rushikesh-D69/tara_hardware/docs/README.md

# docs/ — Documentation

Project documentation for the TARA ADAS system.

---

## Contents

| File | Description |
|---|---|
| `setup_guide.md` | Step-by-step hardware wiring, OS setup, and first-run instructions |

---

## See Also

- [`../walkthrough.md`](../walkthrough.md) — End-to-end system walkthrough
- [`../rpi/README.md`](../rpi/README.md) — Raspberry Pi software reference
- [`../esp32/README.md`](../esp32/README.md) — ESP32 firmware and dashboard reference
