rushikesh-D69/tara_hardware/docs/PICS/README.md

# docs/PICS — Photo Gallery

Real hardware photos and generated diagrams from the TARA project.

---

## Real Hardware Photos

| File | Description |
|---|---|
| `Final_position.png` | TARA mid-circuit — full arena view with car, signs, and traffic light |
| `Final_track.jpeg` | Top-down view of the complete test track (before car is placed) |
| `Turning_Seq.png` | Robot executing a turn at a directional landmark |
| `road_track.jpeg` | Camera-level view of a directional sign inside the lane |
| `PIN CONNECTIONS IN SCHEMATIC.jpeg` | ESP32 GPIO reference (TB6612FNG, HC-SR04, MPU-6050, encoders) |
| `TARA-Circuit Schematic -1.png` | Full circuit schematic (Fritzing) |
| `obstrucle_detection_avoidance.gif` | Demo GIF of obstacle detection and avoidance manoeuvre |
| `tara_live_camera_view.html` | Standalone HTML viewer for the MJPEG debug stream |

---

## Generated / Enhanced Images

| File | Description |
|---|---|
| `tara_robot_hero.png` | Enhanced photo — TARA on track, cinematic edit |
| `tara_track_overview.png` | Enhanced track top-down with highlighted lane lines and signs |
| `tara_live_debug.png` | Enhanced lab photo showing MJPEG debug stream on laptop |
| `tara_system_architecture.png` | System architecture diagram (RPi ↔ ESP32 ↔ Dashboard) |

---

## Track Legend

The indoor test arena uses:
- **White insulation tape** — dual lane lines on glossy marble floor
- **Blue circular signs** — directional arrows (left, right, straight)
- **Red STOP sign** — triggers TSR hard stop
- **Smartphone** — displays traffic light image for TLR testing

All images are referenced in [`../../walkthrough.md`](../../walkthrough.md).
