rushikesh-D69/tara_hardware/docs/PICS/Final_position.png

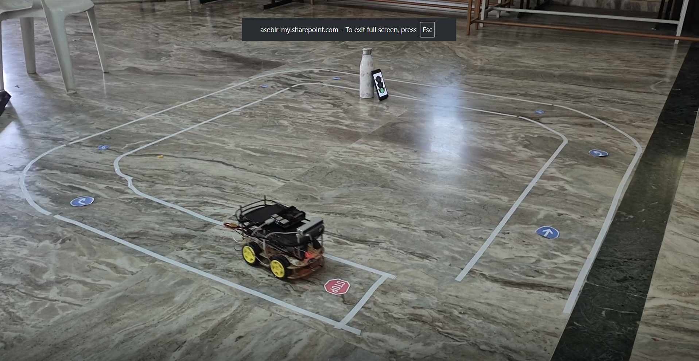
docs/PICS/Final_position.png
