rushikesh-D69/tara_hardware/docs/PICS/Final_track.jpeg

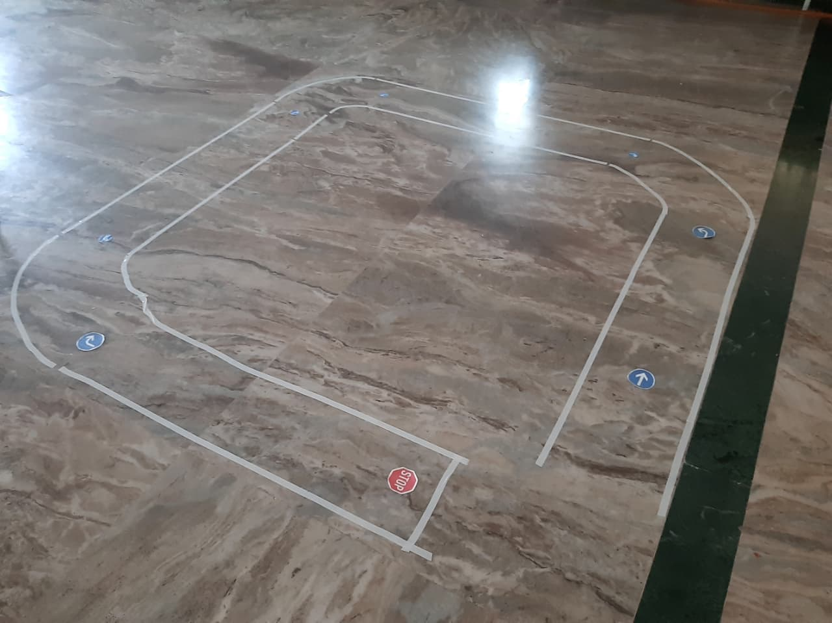
docs/PICS/Final_track.jpeg
