rushikesh-D69/tara_hardware/docs/PICS/PIN CONNECTIONS IN SCHEMATIC.jpeg

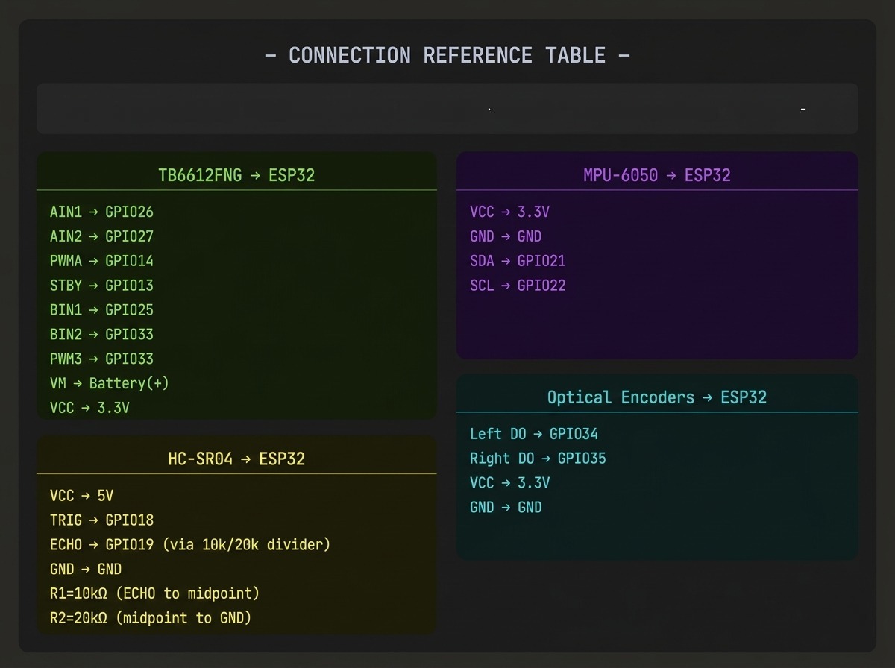
docs/PICS/PIN CONNECTIONS IN SCHEMATIC.jpeg
