rushikesh-D69/tara_hardware/docs/PICS/Proposed_track.jpeg

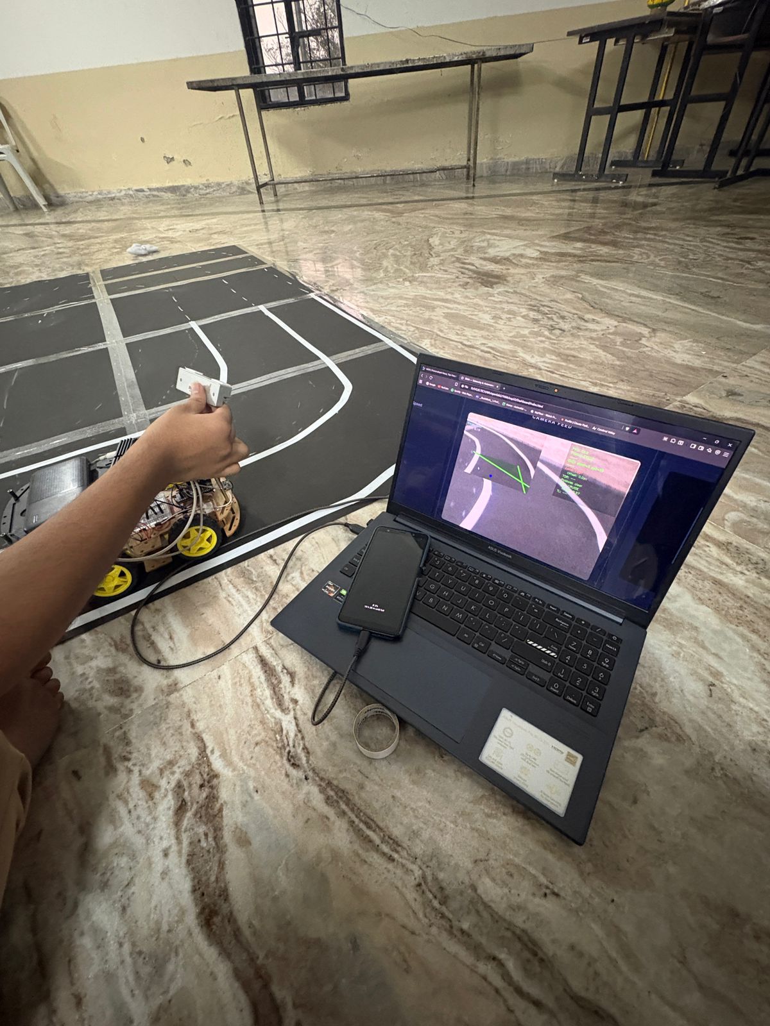
docs/PICS/Proposed_track.jpeg
