rushikesh-D69/tara_hardware/docs/PICS/road_track.jpeg

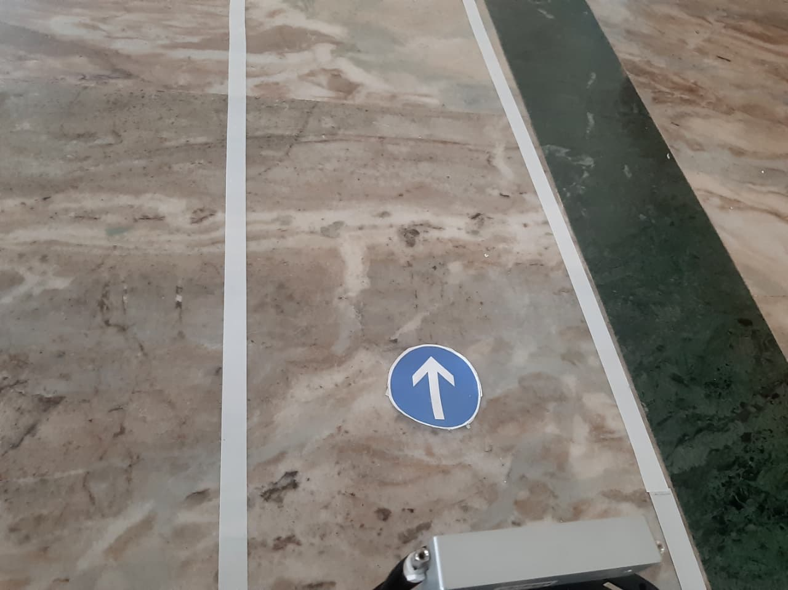
docs/PICS/road_track.jpeg
