rushikesh-D69/tara_hardware/docs/PICS/TARA-Circuit Schematic -1.png

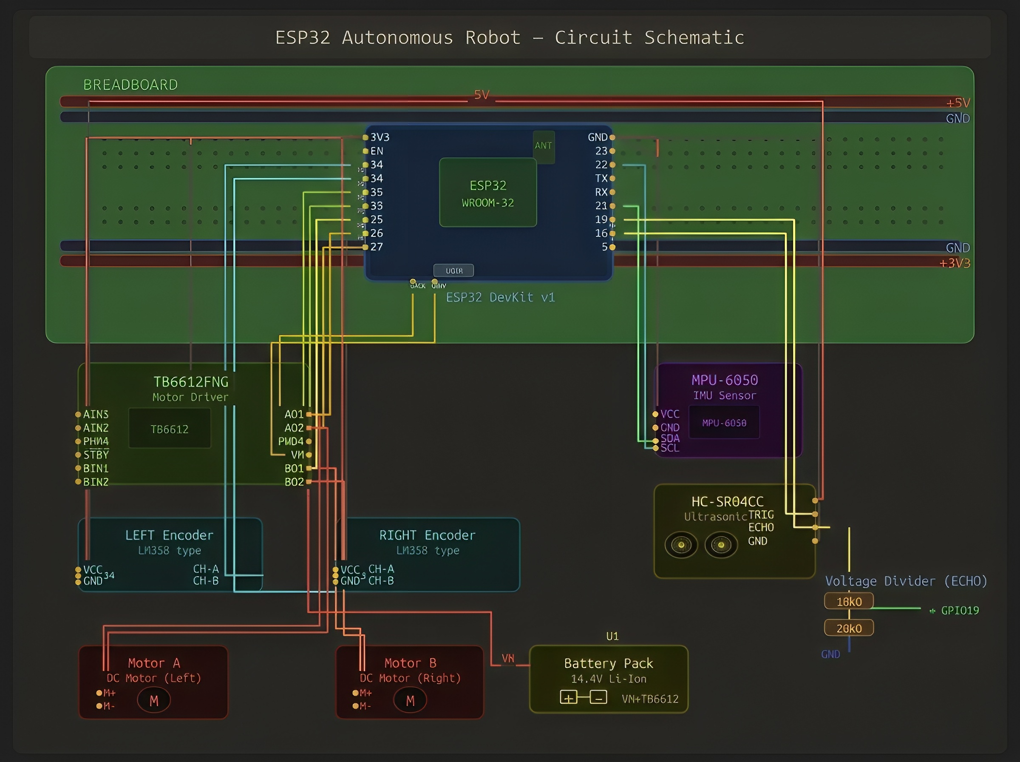
docs/PICS/TARA-Circuit Schematic -1.png
