rushikesh-D69/tara_hardware/docs/PICS/Turning_Seq.png

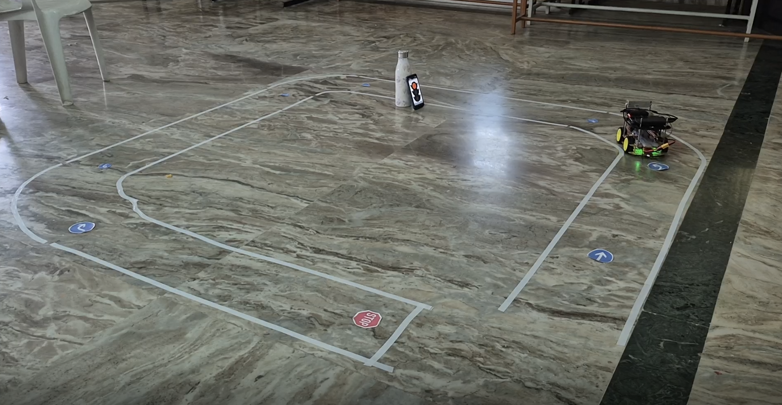
docs/PICS/Turning_Seq.png
