rushikesh-D69/tara_hardware/rpi/print_sheets/traffic_signs.pdf

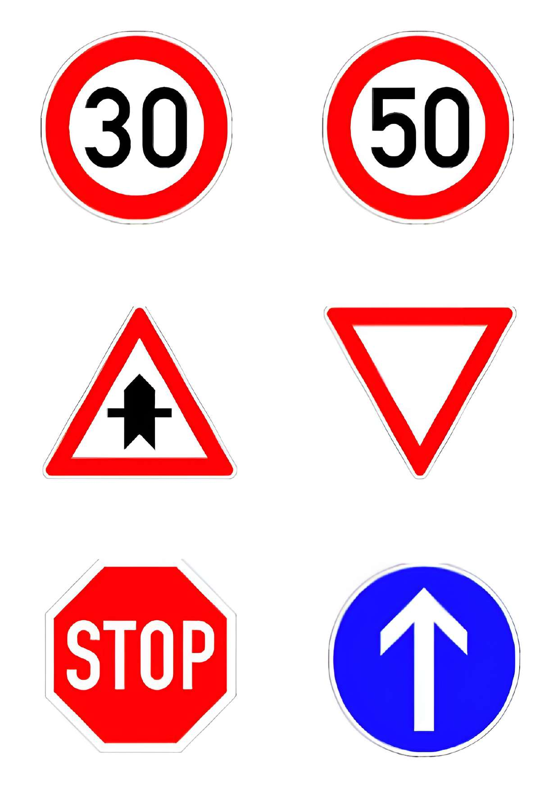
[picture p12: page 1]
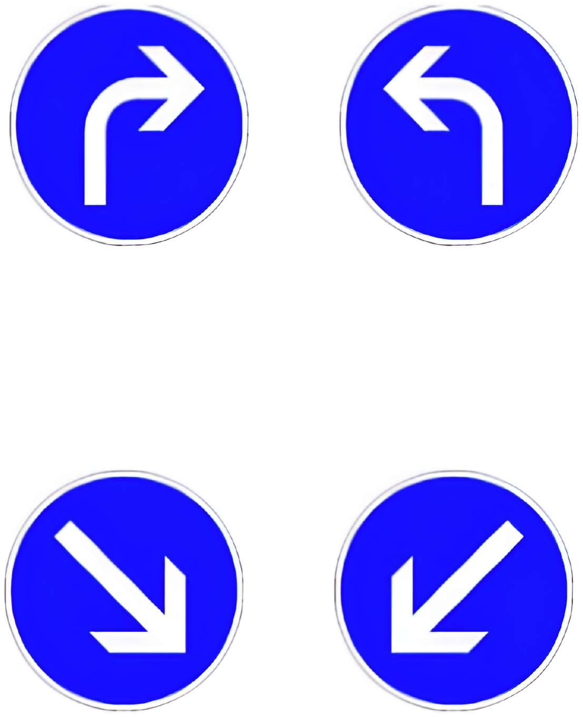
[picture p13: page 2]
