rushikesh-D69/tara_hardware/rpi/print_sheets/sign_sheet_2.png

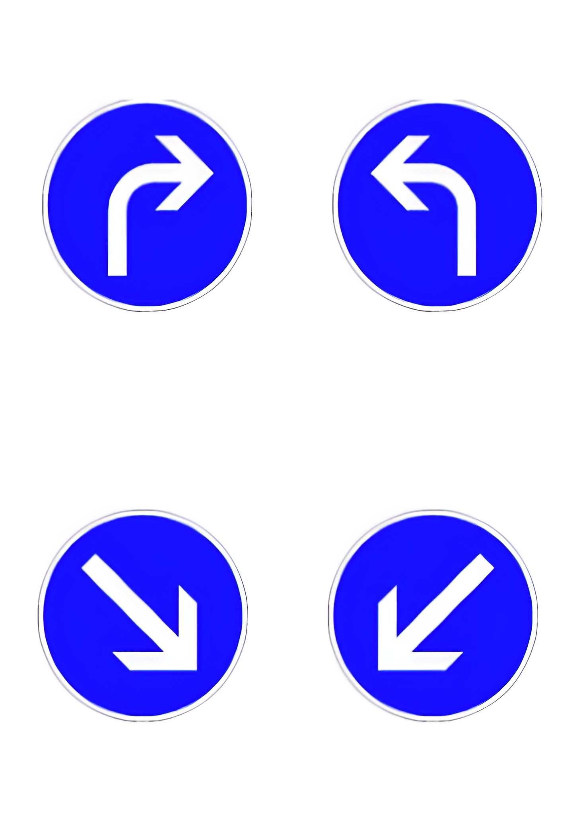
rpi/print_sheets/sign_sheet_2.png
