rushikesh-D69/tara_hardware/(commit log)

2026-04-28 Complete ADAS improvements for indoor track, serial fixes, and startup safety
    [partitions.csv]
2026-04-29 feat: migrate to full WiFi-only architecture - Remove UART serial, add WebSocket RPi client (ws_bridge.py) - ESP32: dual-client WS routing (Dashboard vs RPi by registration handshake) - Remove serial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
2026-04-29 fix: Python 3.12 / Trixie compatibility - add ai-edge-litert TFLite fallback - Update requirements.txt: tflite-runtime -> ai-edge-litert - Add 3-tier TFLite import chain in pothole_detection and traf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
2026-04-29 refactor: replace all tflite-runtime with ai-edge-litert (Python 3.12 clean) - pothole_detection.py: single ai_edge_litert.interpreter.Interpreter import - traffic_sign.py: same clean import, no fall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
2026-04-29 config: update ESP32_HOST IP address
2026-04-29 fix: ws_bridge auto-reconnect + dashboard mode toggle loop - ws_bridge: null _ws on close to stop dead-socket spam - ws_bridge: update self._ws on reconnect in _on_open - ws_bridge: mark disconnected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
2026-04-29 fix: increase RPi auto watchdog 1500ms→5000ms to prevent false timeouts on WiFi jitter
    [ESP32-Web.ino]
2026-04-29 fix: immediately revert to MANUAL on RPi disconnect (don't wait for watchdog)
    [WsHandler.cpp]
2026-04-29 fix: watchdog only fires when RPi is registered, reset timer on set_mode:auto
    [ESP32-Web.ino, WsHandler.cpp]
2026-04-29 feat: replace cv2.imshow with MJPEG HTTP stream for headless debug - Add MJPEG server on port 5000 (zero extra deps, uses http.server) - --debug now streams annotated frames to http://RPI_IP:5000/ - 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
2026-04-29 feat: wire dashboard camera panel to RPi MJPEG stream at port 5000 - Add RPI_IP config in script.js - Stream auto-starts from http://RPI_IP:5000/stream when RPi runs --debug - Add offline placeholder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
2026-04-29 fix: auto-start camera stream and add retry logging
2026-04-29 rem: remove all watchdog timers and connection fallbacks - RPi silent or disconnected no longer forces MANUAL mode
    [ESP32-Web.ino, WsHandler.cpp]
2026-04-29 fix: motor movement + add RPi command echo - Tasks: remove internal watchdogs killing motors - WsHandler: broadcast auto_cmd as rpi_cmd - script.js: handle and log rpi_cmd (throttled)
    [Tasks.cpp, WsHandler.cpp]
2026-04-29 rem: final purge of all watchdog and timeout logic from ESP32 and Dashboard
2026-04-29 fix: unify all movement commands to JSON format - Dashboard: convert CMD: loop to JSON drive object - RPi: fix steer/speed attribute mapping in WsBridge - Remove redundant joystick event calls
2026-04-29 fix: correctly serialize RPi Command object to JSON using to_ws() or steer_x/speed_y attributes
2026-04-29 tune: improve lane following and safety - lower speed to 160 PWM - remove steering deadband - increase steering gain to 1.2x - reduce smoothing for faster response - implement emergency stop on 10-fr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
2026-04-29 tune: drop default speed to 145 PWM for slow-crawl debugging
2026-04-29 fix: improve joystick control - add manual override to abort navMode on joystick input - lower floorPwm to 135 for smoother slow-speed steering
    [Tasks.cpp, WsHandler.cpp]
2026-04-30 Implement OpenCV-based blue sign detection and landmark-triggered steering bias
2026-05-01 Optimize traffic sign detection for ground-pasted signs and improve turn maneuvers
2026-05-01 Add brute-force lane follower for indoor track demo
2026-05-01 Implement robust brute-force lane detection and optimize steering control
2026-05-01 Add pin connections schematic and car photo to documentation
2026-05-01 Finalize brute-force lane centering logic and torque optimization for indoor track
2026-05-01 Add time-based sequence driving script for square track
2026-05-06 Implement single-lane detection fallback for track turn tyoe CamChbcs
